MeghanaM4/Hermes/README.md

# Hermes
make a PCB with an on-board sensor to transmit data via I2C, get the money to build it

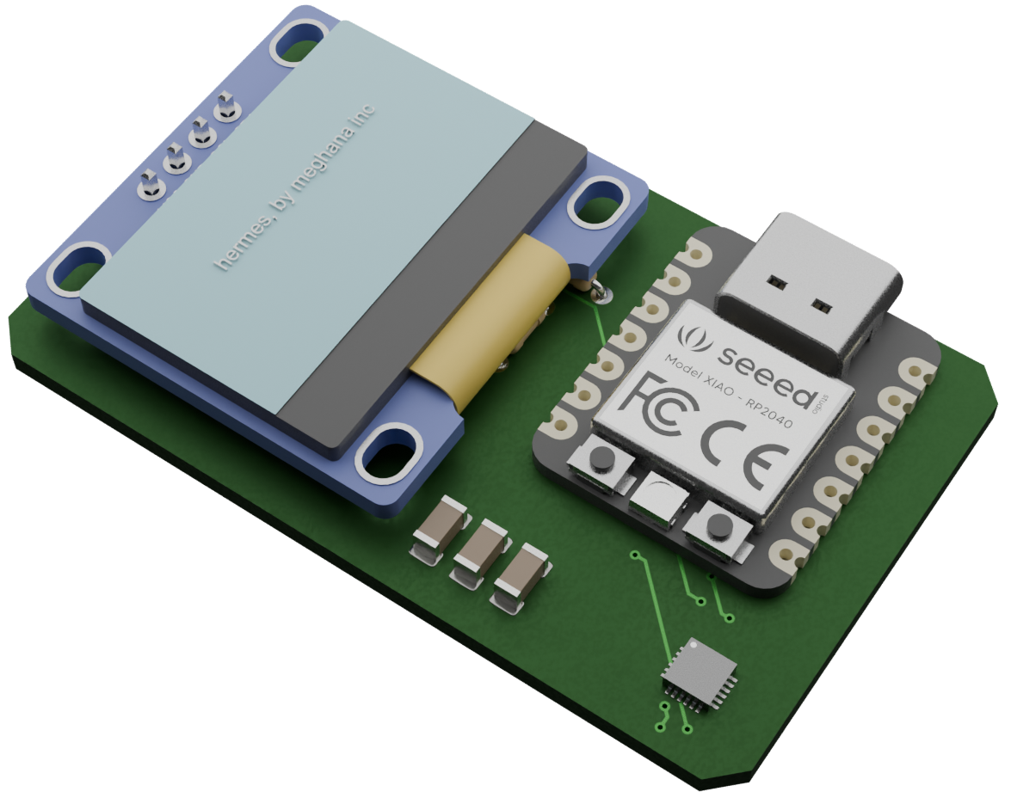
[picture p1: imgs/render2.png]
