MeghanaM4/Hermes/KiCAD/hermes.kicad_pcb

## KiCad design KiCAD/hermes.kicad_pcb (2025-10-27)

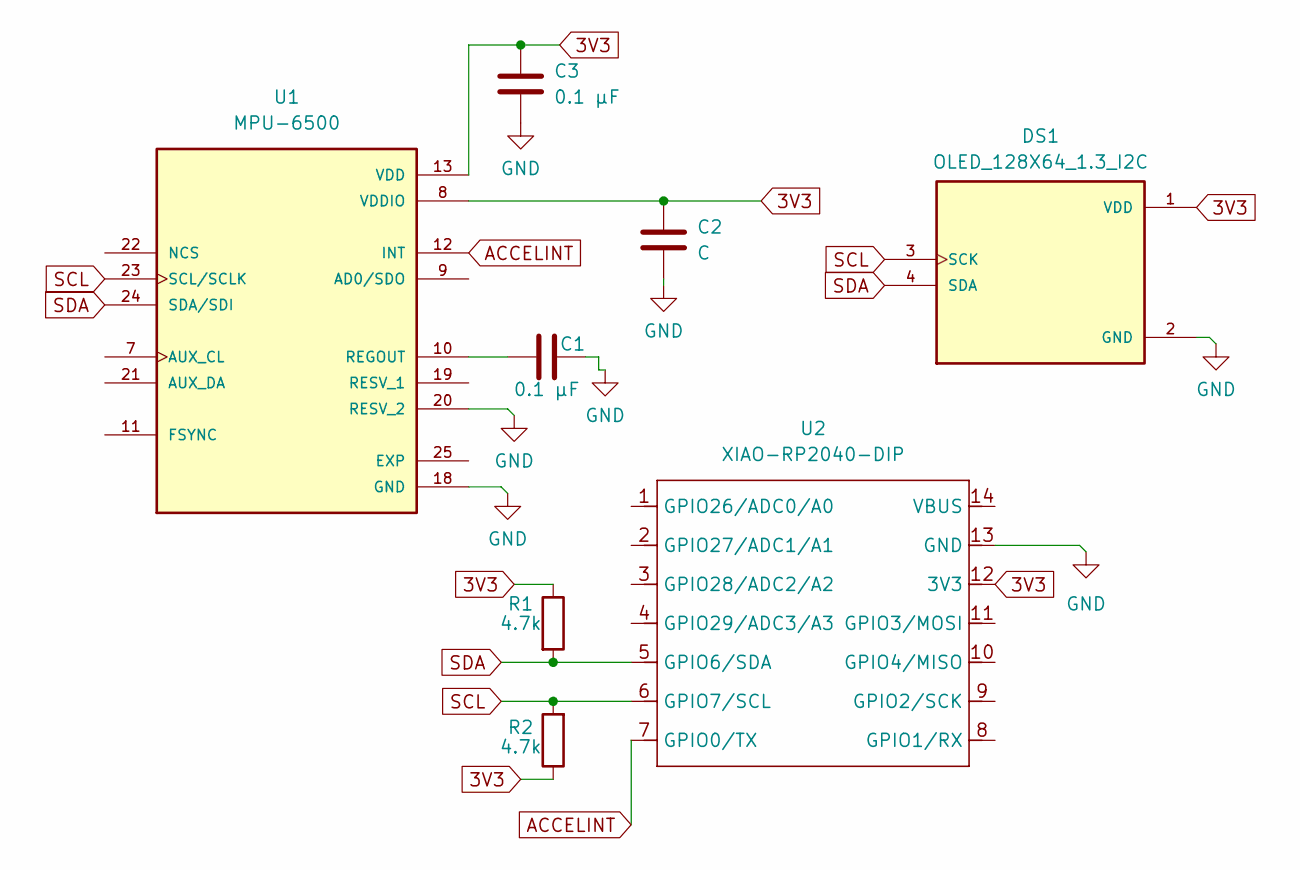
[picture p2: schematic hermes.kicad_sch]

Parts:
C1, C3: 0.1 µF; C_1206_3216Metric
C2: C; C_1206_3216Metric
DS1: OLED_128X64_1.3_I2C; 128x64OLED; PARTREV NA
R1, R2: 4.7k; R_Axial_DIN0204_L3.6mm_D1.6mm_P5.08mm_Horizontal
U1: MPU-6500; QFN40P300X300X95-25N; PARTREV 1.3
U2: XIAO-RP2040-DIP

Connections:
3V3: C2.1, C3.1, DS1.1 (VDD), R1.1, R2.1, U1.8 (VDDIO), U1.13 (VDD), U2.12 (3V3)
ACCELINT: U1.12 (INT), U2.7 (GPIO0/TX)
GND: C1.2, C2.2, C3.2, DS1.2 (GND), U1.18 (GND), U1.20 (RESV_2), U2.13 (GND)
unnamed: C1.1, U1.10 (REGOUT)
SCL: DS1.3 (SCK), R2.2, U1.23 (SCL/SCLK), U2.6 (GPIO7/SCL)
SDA: DS1.4 (SDA), R1.2, U1.24 (SDA/SDI), U2.5 (GPIO6/SDA)

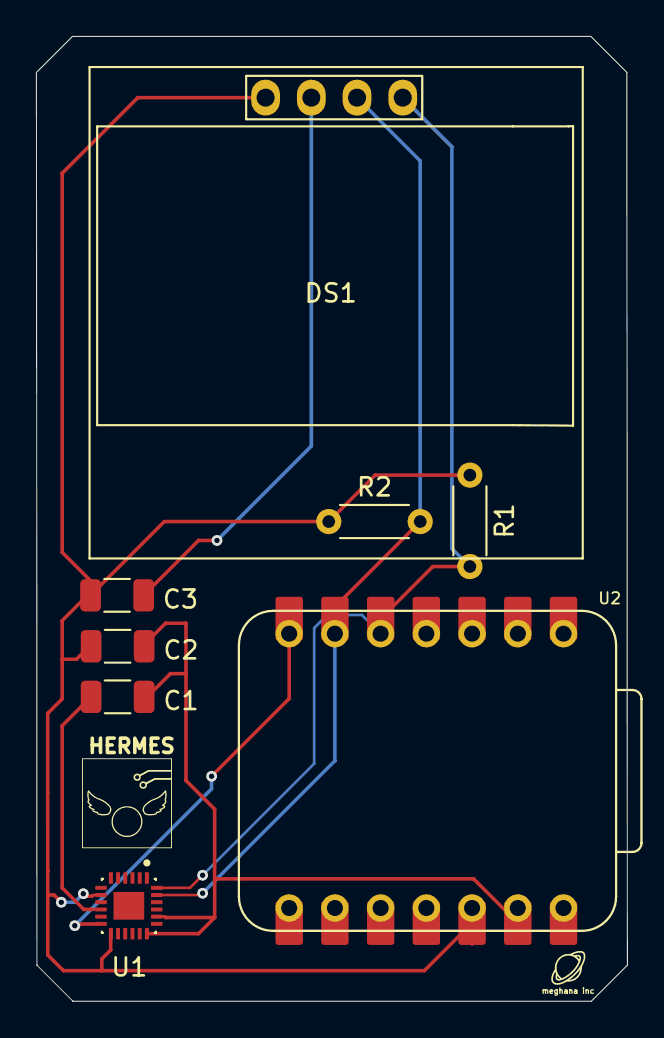
[picture p3: board hermes.kicad_pcb from above]

Board: 2 copper layers, 32.8 x 53.6 mm, 8 parts (0 on the bottom side), 6 nets.
