MeghanaM4/Hermes/steps/step1.html

back to map

# Step 1: KiCAD Wakatime Setup

ALERT: To make a Hermes, you need to have completed Pathfinder (https://pathfinder.hackclub.com). Unless you're confident in your ability to design and make a PCB without heavy guidance. Pathfinder is super quick--and the guide is insanely detailed and beginner friendly. If you're looking to get into hardware, step 1 is Pathfinder and step 2 is Hermes.

To download and install KiCAD, follow the tutorial on the pathfinder website (https://pathfinder.hackclub.com)! Step 1 is setting up KiCAD.

To start your download, go to kicad.org/download

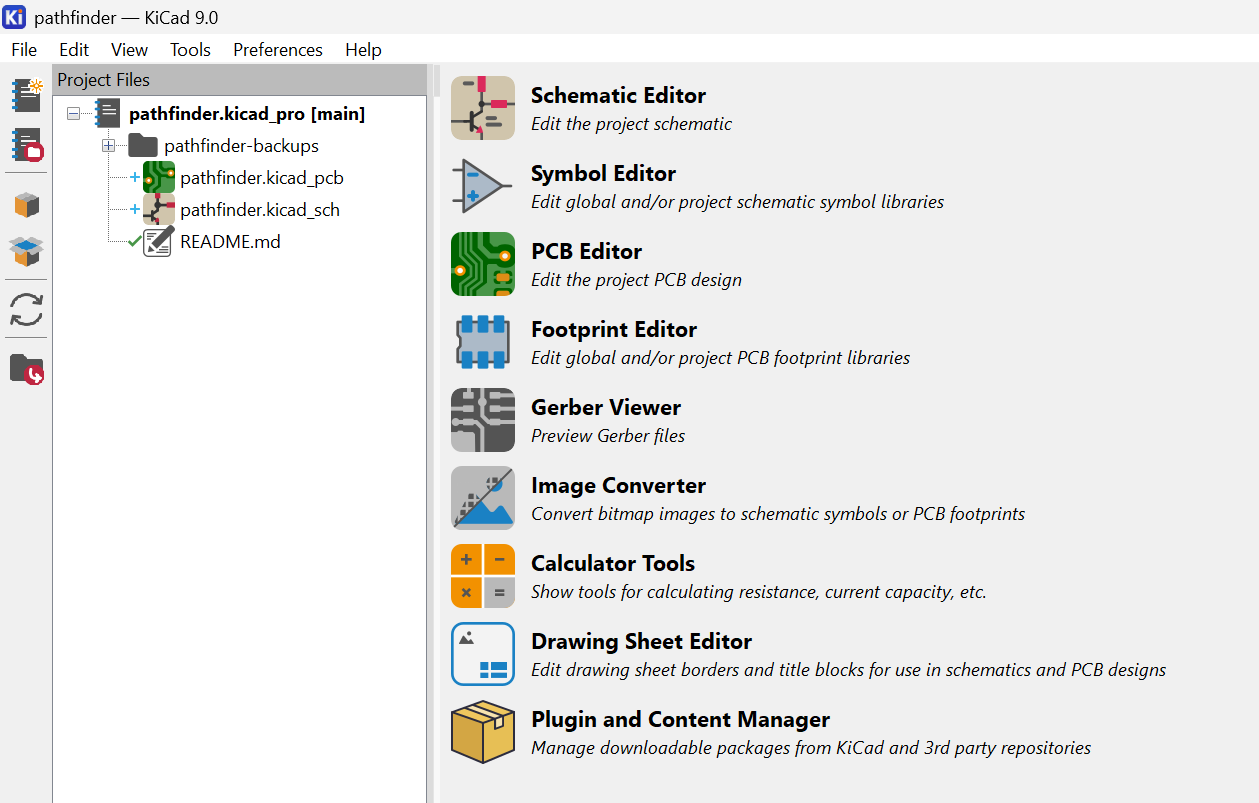
[picture p9: public/stepimgs/step1.1.png]




To properly track your time spent on Hermes, download Cyao's KiCAD Wakatime (https://github.com/hackclub/kicad-wakatime/releases/tag/0.3.0)! Each time you open KiCAD, make sure to open KiCAD wakatime so that it tracks. If you don't open it every time you work on your PCB, it won't track your time.

When you create a new project, go to KiCAD Wakatime's settings and set the filepath of your project.

next step >>
