MeghanaM4/Hermes/(commit log)

2025-07-11 buncha stuff
    [hermes.kicad_pcb, hermes.kicad_sch]
2025-07-17 step 3 + 4
    [hermes.kicad_pcb, hermes.kicad_sch]
2025-07-23 help button formatting + philosophy
2025-10-27 fixed pullups
    [hermes.kicad_pcb, hermes.kicad_sch]
2025-10-27 PCB update
